myml12/Morse_Keyboard/outputs/blender_keyer/morse_keyer_exterior.png

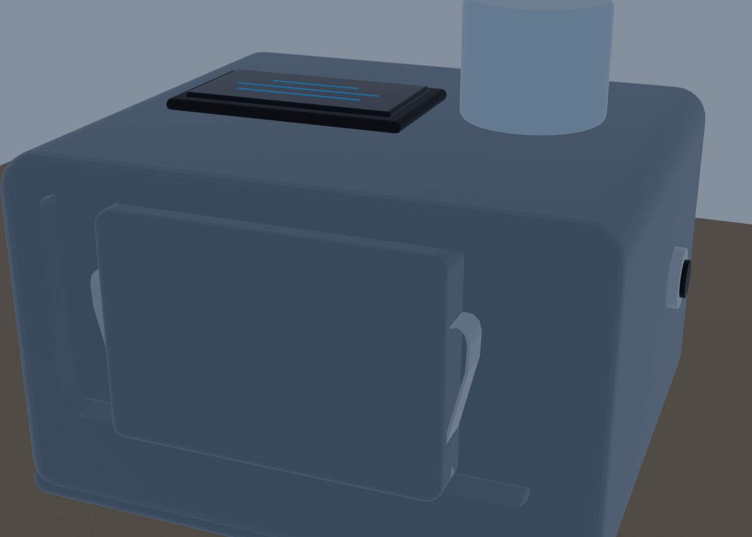
outputs/blender_keyer/morse_keyer_exterior.png
