myml12/Morse_Keyboard/outputs/blender_keyer/morse_keyer_magnetic_base.png

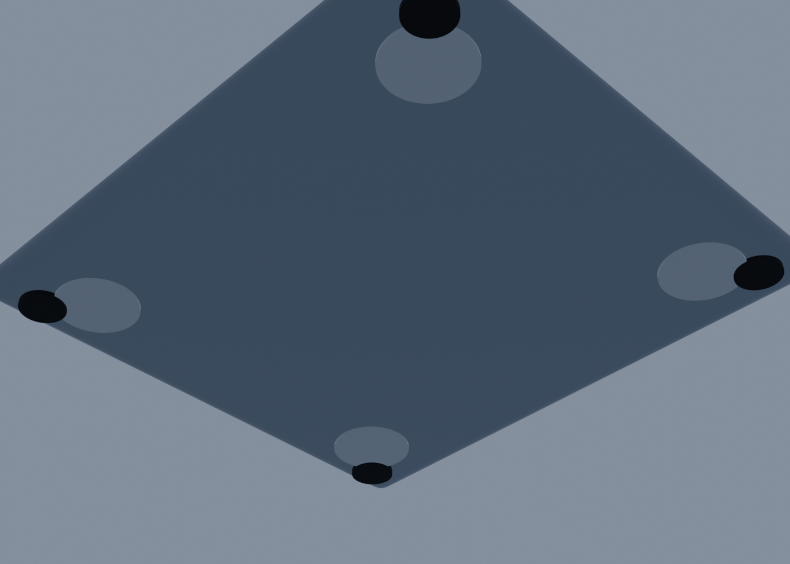
outputs/blender_keyer/morse_keyer_magnetic_base.png
