myml12/Morse_Keyboard/outputs/blender_keyer/morse_keyer_switch_mechanism.png

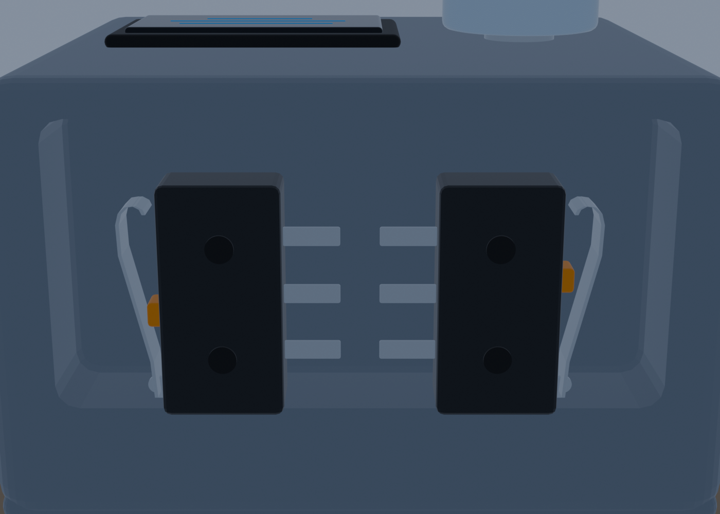
outputs/blender_keyer/morse_keyer_switch_mechanism.png
