myml12/Morse_Keyboard/outputs/morse_keyboard_bom/モールスキーボード_部品表.xlsx

モールスキーボード 部品表（秋月電子価格参照）
価格確認日：2026-07-21 ｜ 金額は税込 ｜ 送料・PCB製造費・筐体は含まない
区分 | 部品名 | 販売コード | 型番・仕様 | 実装数 | 購入単位 | 購入数 | 単価（税込） | 小計（税込） | 秋月電子 商品ページ
主要部品 | 0.96インチ 128×64ドット有機ELディスプレイ（OLED） 白色 | 112031 | SSD1306／I2C／白色 | 1 | 個 | 1 | ¥580 | ¥580 | https://akizukidenshi.com/catalog/g/g112031/
主要部品 | Seeed Studio XIAO ESP32C3 | 117454 | 113991054 | 1 | 個 | 1 | ¥1080 | ¥1080 | https://akizukidenshi.com/catalog/g/g117454/
操作部 | 2色LED付スイッチ付ロータリーエンコーダー（赤・青）ツマミ付セット | 105772 | EC12PLBRSDVF-D-25K-24-24C-31/0 | 1 | セット | 1 | ¥270 | ¥270 | https://akizukidenshi.com/catalog/g/g105772/
受動部品 | カーボン抵抗（炭素皮膜抵抗） 1/4W 1kΩ | 125102 | CF25J1KB／1袋100本入 | 1 | 袋（100本） | 1 | ¥100 | ¥100 | https://akizukidenshi.com/catalog/g/g125102/
操作部 | マイクロスイッチ SS-10GL13 | 114659 | SS-10GL13 | 2 | 個 | 2 | ¥160 | ¥320 | https://akizukidenshi.com/catalog/g/g114659/
音響 | 電子ブザー 12mm UGCM1205XP | 109800 | UGCM1205XP | 1 | 個 | 1 | ¥110 | ¥110 | https://akizukidenshi.com/catalog/g/g109800/
秋月電子 部品購入合計（税込・送料除く） |  |  |  |  |  |  |  | ¥2460
PCB化メモ
・ブレッドボードおよびジャンパ線は、最終版では使用しないため購入合計から除外。
・PCB製造費は基板サイズ、枚数、レイヤー数、表面処理、送料で変動するため、見積もり確定後に別途追加。
・XIAO ESP32C3、OLED、ロータリーエンコーダー、マイクロスイッチ、ブザー、抵抗はいずれもスルーホール／モジュール実装を想定。
・抵抗は100本入りのため、実装は1本でも購入費には1袋分を計上。
更新方法：購入数（G列）または単価（税込）（H列）を変更すると、小計と購入合計が自動で更新されます。
