myml12/Morse_Keyboard/outputs/morse_keyboard_bom/preview.png

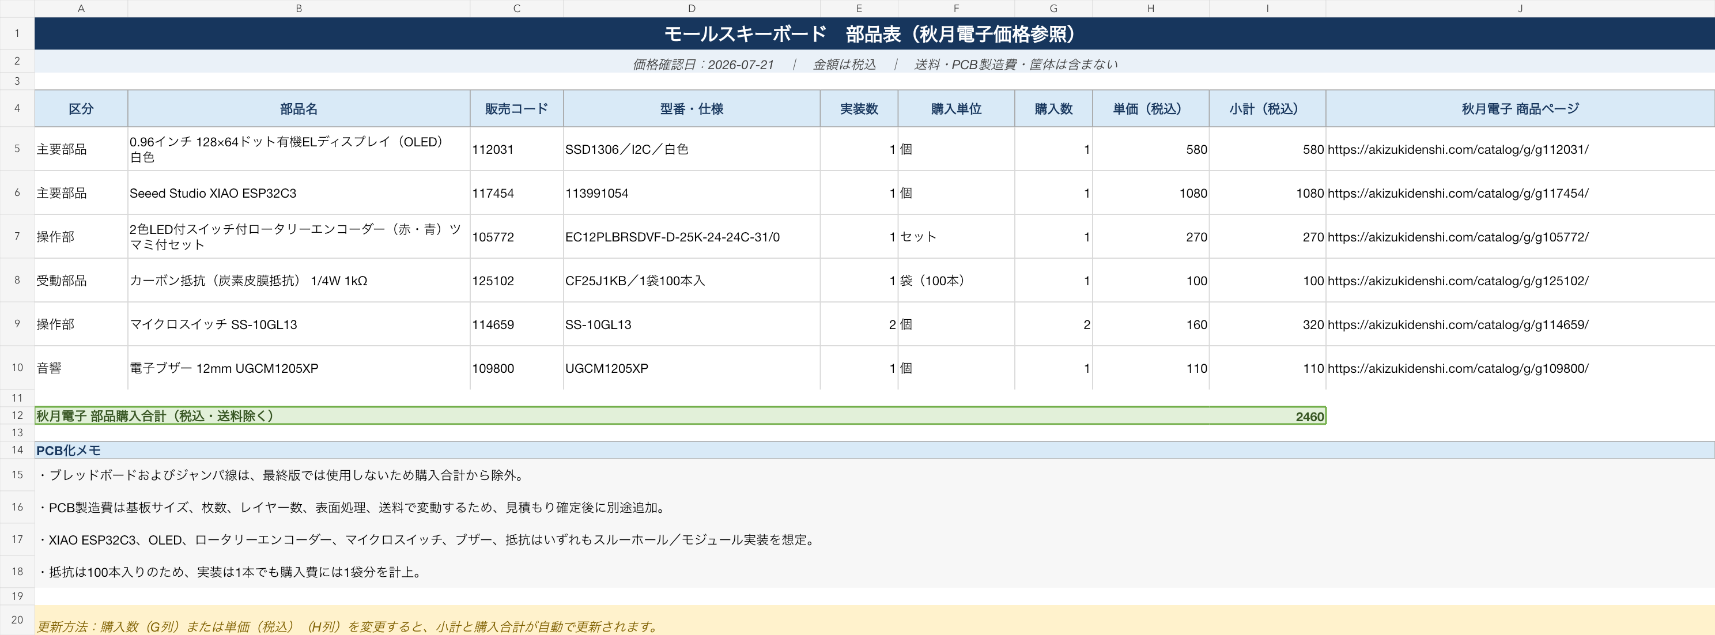
outputs/morse_keyboard_bom/preview.png
