myml12/Morse_Keyboard/(list of files, cad)

Other CAD files:
outputs/blender_keyer/morse_keyer_concept.blend
