myml12/Morse_Keyboard/(commit log)

2026-07-20 文字確定タイミングを修正
2026-07-20 ディスプレイとエンコーダを追加
2026-07-21 パーツリストを追加
    [morse_keyer_concept.blend, モールスキーボード_部品表.xlsx]
